deaxx/ptvo_flower_multisensor/README.md

# PTVO Flower multiSensor

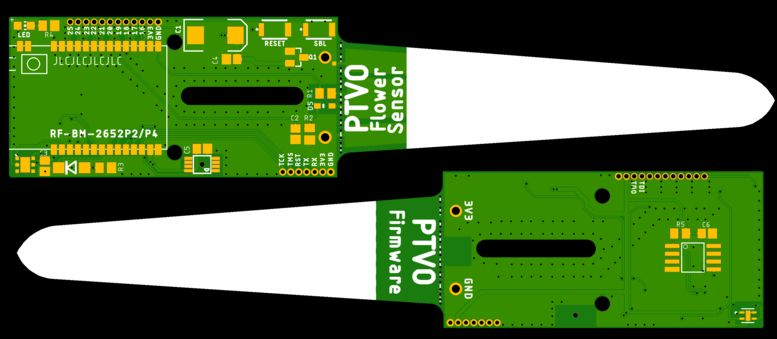
[picture p1: ptvo_fs.jpg]
Top layer
