deaxx/ptvo_flower_multisensor/CC2652RB/README.md

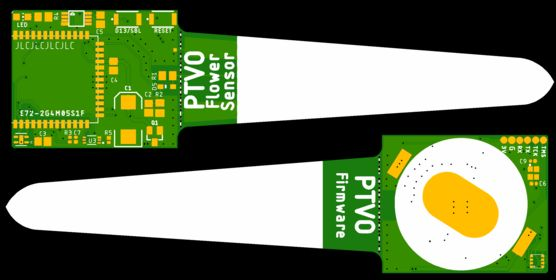
[picture p2: CC2652RB/ptvo_fs.jpg]
Top layer


### Components:
E72-2G4M05S1F - https://aliexpress.ru/item/1005006060110453.html

Cell Holder CR2450 - https://aliexpress.ru/item/33036966276.html

Micro Button Tact Switch SMD 2Pin - https://aliexpress.ru/item/1005001629364313.html

DS18B20U MSOP-8 - https://aliexpress.ru/item/32903017916.html

Quartz Oscillator 48 MHz - https://aliexpress.ru/item/1005001781710042.html

### Information:

For lower power consumption of the E72-2G4M05S1F module, it is recommended to install a quartz oscillator at 48 MHz.

With a 48 MHz quartz oscillator installed, flash the E72-2G4M05S1F module with PTVO firmware for the CC2652R chip
