deaxx/ptvo_flower_multisensor/CC2652RB/ptvo_fs.png

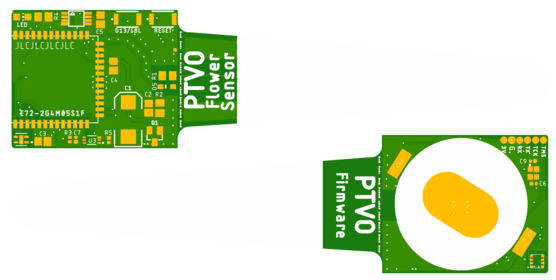
CC2652RB/ptvo_fs.png
