deaxx/ptvo_flower_multisensor/CC2652RB/ptvo_fs_sch.png

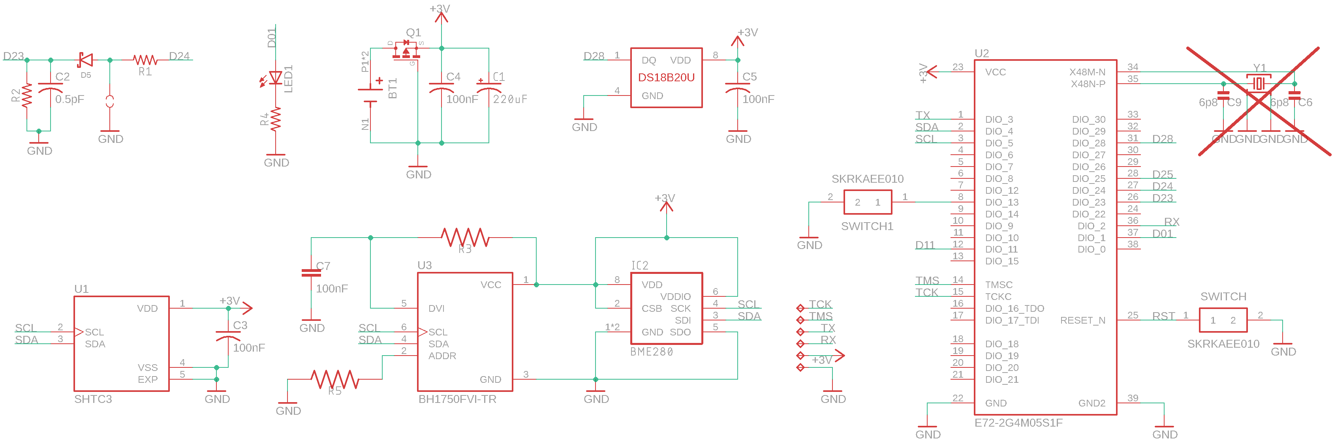
CC2652RB/ptvo_fs_sch.png
