deaxx/ptvo_flower_multisensor/ptvo_fs.png

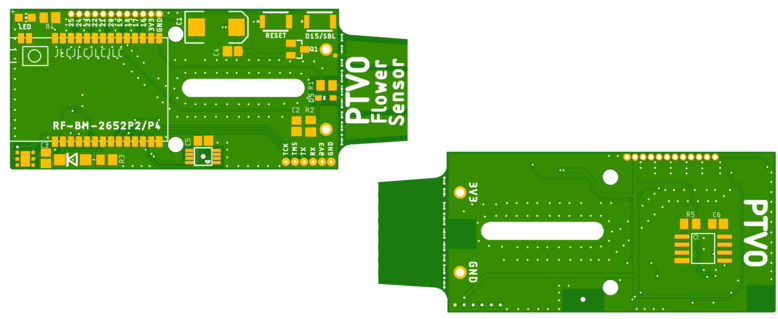
ptvo_fs.png
