deaxx/ptvo_flower_multisensor/ptvo_fs_sch.png

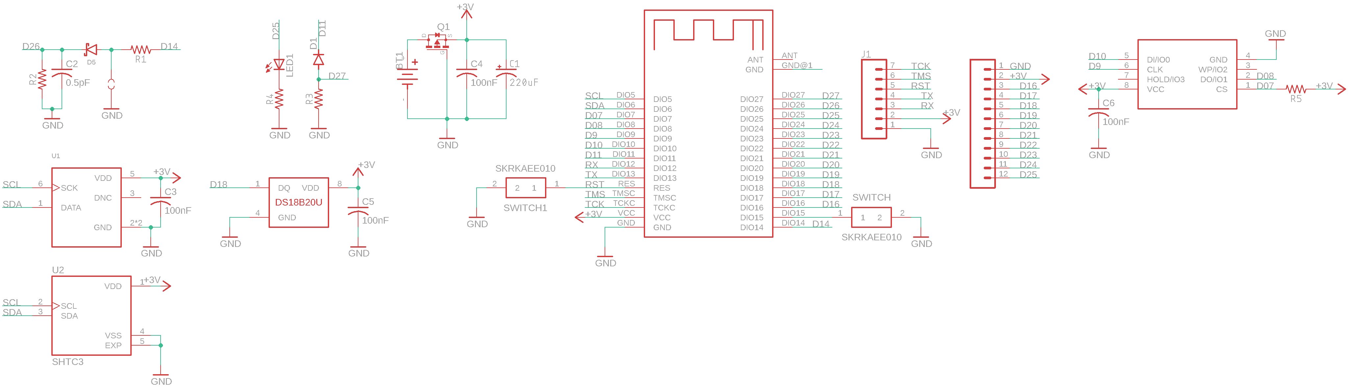
ptvo_fs_sch.png
