deaxx/ptvo_flower_multisensor/ptvo_fs_bom.xls

Qty | Value | Device | Package | Parts | Links
1 |  | LEDCHIP-LED0805 | CHIP-LED0805 | LED1 | https://aliexpress.ru/item/4000936781234.html
1 |  | RF-BM-2652P2 | RF-BM-2652P2 | U$1 | https://aliexpress.ru/item/1005001677721370.html
1 | 0.5pF | C-USC0805 | C0805 | C2
4 | 100nF | C-USC0805 | C0805 | C3, C4, C5, C6
2 | 10k | R-US_M0805 | M0805 | R1, R3
1 | 1M | R-US_M0805 | M0805 | R2
1 | 1N4148WS | DIODE-SCHOTTKY | SOD-323 | D5 | https://aliexpress.ru/item/32921490945.html
2 | 2.2k | R-US_M0805 | M0805 | R4, R5
1 | 220uF | 100UF-POLAR-EIA7343-10V-10%(TANT) | EIA7343 | C1 | https://aliexpress.ru/item/1005002065363485.html
1 | BH2AAAPC | BH2AAAPC | BAT_BH2AAAPC | BT1 | https://aliexpress.ru/item/1005003172823044.html
1 | DS18S20USOP8 | DS18S20USOP8 | UMAX8 | IC1 | https://aliexpress.ru/item/1005004662413243.html
1 | HTU21D | HTU21D | QFN100P300X300X100-7N | U1 | https://aliexpress.ru/item/1005005345789993.html
1 | IS25LP080D | W25Q80BVSNIG | SO-8 | U$2 | https://aliexpress.ru/item/32898528477.html
1 | PTSMD3528 | DIODE-DO214BA | DO214BA | D1 | https://aliexpress.ru/item/1005005334593298.html
1 | SI2323DS | SI2323DS | SOT23 | Q1 | https://aliexpress.ru/item/1005003928154282.html
2 | SKRKAEE010 | SKRKAEE010 | SKRK | SWITCH, SWITCH1 | https://aliexpress.ru/item/32996753966.html
1 | SHTC3 | SHTC3 | SON100P200X200X80-5N | U2 | https://aliexpress.ru/item/1005005492313006.html
