deaxx/ptvo_flower_multisensor/CC2652RB/ptvo_fs.brd

## EAGLE design CC2652RB/ptvo_fs.brd (2024-04-08)

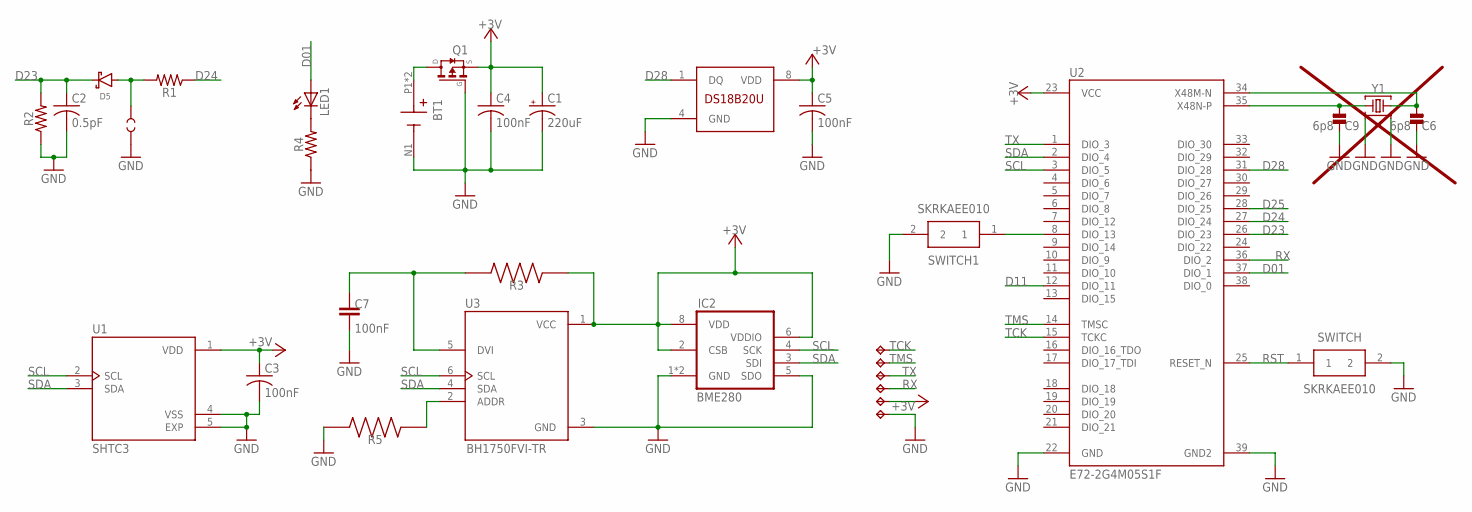
[picture p7: schematic ptvo_fs.sch]

Parts:
BT1: BAT-HLD-001; BAT_BAT-HLD-001
C1: 220uF; EIA7343
C2: 0.5pF; C0805
C3, C4, C5: 100nF; C0805
C6, C9: 6p8; _PKG_C_0402
C7: 100nF; CAPC1005X40N
D5: 1N4148WS; SOD-323
IC1: DS18S20USOP8; UMAX8
IC2: BME280
LED1: LEDCHIP-LED0805; CHIP-LED0805
Q1: SI2323DS; SOT23
R1: 10k; M0805
R2: 1M; M0805
R3, R5: 4.7k; RESC1005X40N
R4: 2.2k; M0805
SWITCH, SWITCH1: SKRKAEE010; SKRK
TP1, TP2: TEST-POINT2; PAD.02X.02
TP3, TP4, TP5, TP6, TP7, TP8: TPB1,27; B1,27
U1: SHTC3; SON100P200X200X80-5N
U2: E72-2G4M05S1F
U3: BH1750FVI-TR; XDCR_BH1750FVI-TR
Y1: Q22FA12800150; XTAL-4P-2016

Connections:
+3V3: C1.A (+), C3.1, C4.1, C5.1, IC1.8 (VDD), IC2.2 (CSB), IC2.6 (VDDIO), IC2.8 (VDD), Q1.2 (S), R3.1, TP6.TP, U1.1 (VDD), U2.23 (VCC), U3.1 (VCC)
D01: LED1.A, U2.37 (DIO_1)
D11: U2.12 (DIO_11)
D23: C2.1, D5.C, R2.2, U2.26 (DIO_23)
D24: R1.1, U2.27 (DIO_24)
D25: U2.28 (DIO_25)
D28: IC1.1 (DQ), U2.31 (DIO_28)
GND: BT1.N1 (-), C1.C (-), C2.2, C3.2, C4.2, C5.2, C6.1, C7.2, C9.1, IC1.4 (GND), IC2.1 (GND), IC2.5 (SDO), IC2.7 (GND), Q1.1 (G), R2.1, R4.1, R5.2, SWITCH.2, SWITCH1.2, TP2.P$1, TP7.TP, U1.4 (VSS), U1.5 (EXP), U2.22 (GND), U2.39 (GND2), U3.3 (GND), Y1.2, Y1.4
unnamed: D5.A, R1.2, TP1.P$1
unnamed: LED1.C, R4.2
unnamed: SWITCH1.1, U2.8 (DIO_13)
unnamed: BT1.P1 (+), BT1.P2 (+), Q1.3 (D)
unnamed: C6.2, U2.34 (X48M-N), Y1.3
unnamed: C7.1, R3.2, U3.5 (DVI)
unnamed: R5.1, U3.2 (ADDR)
unnamed: C9.2, U2.35 (X48N-P), Y1.1
RST: SWITCH.1, U2.25 (RESET_N)
RX: TP5.TP, U2.36 (DIO_2)
SCL: IC2.4 (SCK), U1.2 (SCL), U2.3 (DIO_5), U3.6 (SCL)
SDA: IC2.3 (SDI), U1.3 (SDA), U2.2 (DIO_4), U3.4 (SDA)
TCK: TP8.TP, U2.15 (TCKC)
TMS: TP3.TP, U2.14 (TMSC)
TX: TP4.TP, U2.1 (DIO_3)

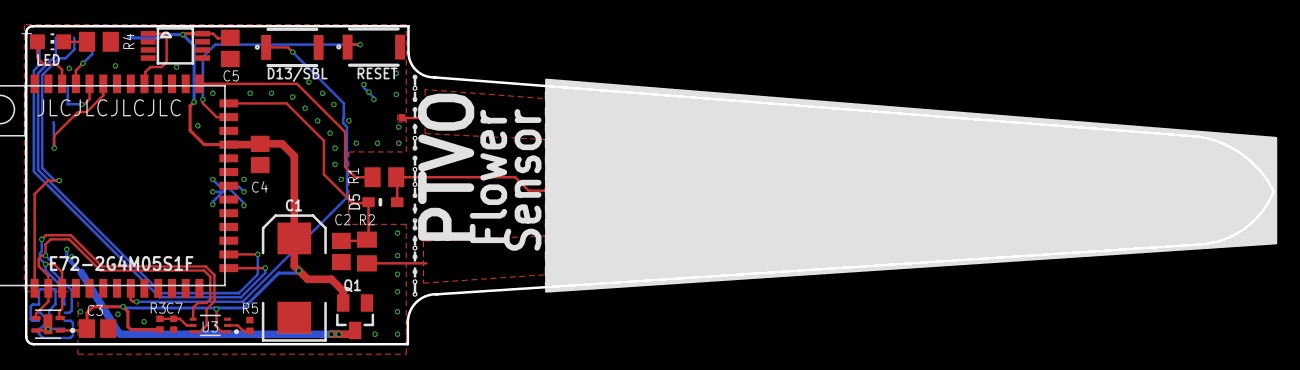
[picture p8: board CC2652RB/ptvo_fs.brd from above]

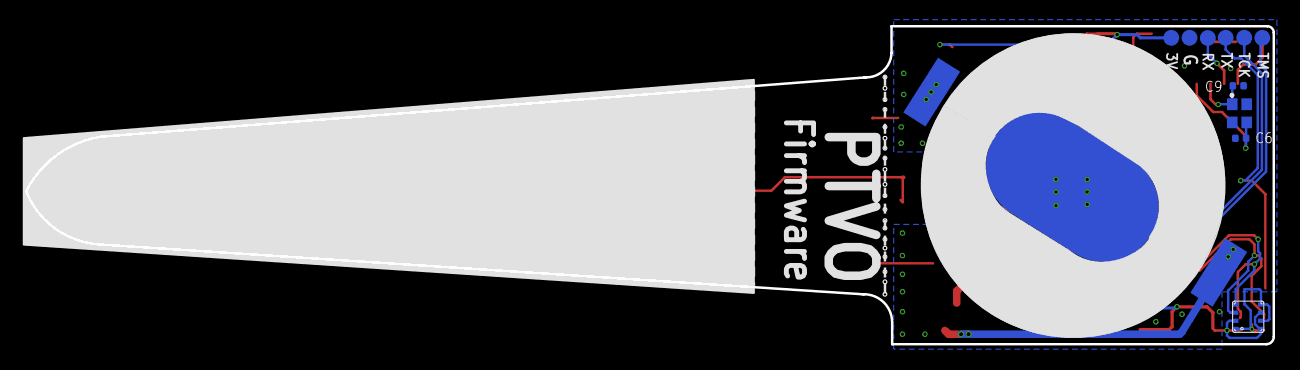
[picture p9: board CC2652RB/ptvo_fs.brd from below]

Board: 2 copper layers, 100.0 x 25.5 mm, 33 parts (11 on the bottom side), 21 nets.
