deaxx/ptvo_flower_multisensor/ptvo_fs.brd

## EAGLE design ptvo_fs.brd (2023-12-28)

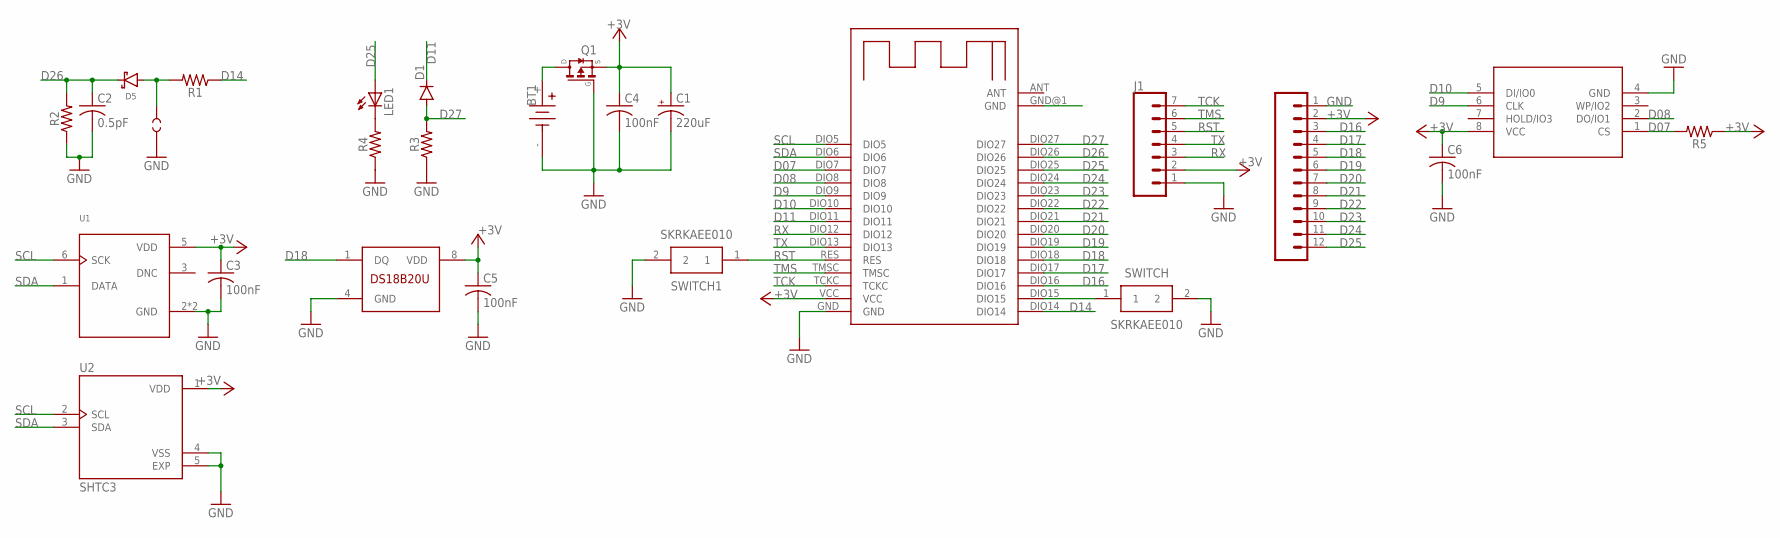
[picture p10: schematic ptvo_fs.sch]

Parts:
BT1: BH2AAAPC; BAT_BH2AAAPC
C1: 220uF; EIA7343
C2: 0.5pF; C0805
C3, C4, C5, C6: 100nF; C0805
D1: PTSMD3528; DO214BA
D5: 1N4148WS; SOD-323
IC1: DS18S20USOP8; UMAX8
J1, J2: CONN_051.27MM; 1X05_1.27MM
LED1: LEDCHIP-LED0805; CHIP-LED0805
Q1: SI2323DS; SOT23
R1, R3: 10k; M0805
R2: 1M; M0805
R4, R5: 2.2k; M0805
SWITCH, SWITCH1: SKRKAEE010; SKRK
TP1, TP2: TEST-POINT2; PAD.02X.02
U1: HTU21D; QFN100P300X300X100-7N
U2: SHTC3; SON100P200X200X80-5N
U$1: RF-BM-2652P2
U$2: IS25LP080D; SO-8

Connections:
+3V3: C1.A (+), C3.1, C4.1, C5.1, C6.1, IC1.8 (VDD), J1.2, J2.2, Q1.2 (S), R5.1, U1.5 (VDD), U2.1 (VDD), U$1.VCC, U$2.8 (VCC)
D07: R5.2, U$1.DIO7, U$2.1 (CS)
D08: U$1.DIO8, U$2.2 (DO/IO1)
D9: U$1.DIO9, U$2.6 (CLK)
D10: U$1.DIO10, U$2.5 (DI/IO0)
D11: D1.C, U$1.DIO11
D14: R1.1, U$1.DIO14
D16: J2.3, U$1.DIO16
D17: J2.4, U$1.DIO17
D18: IC1.1 (DQ), J2.5, U$1.DIO18
D19: J2.6, U$1.DIO19
D20: J2.7, U$1.DIO20
D21: J2.8, U$1.DIO21
D22: J2.9, U$1.DIO22
D23: J2.10, U$1.DIO23
D24: J2.11, U$1.DIO24
D25: J2.12, LED1.A, U$1.DIO25
D26: C2.1, D5.C, R2.2, U$1.DIO26
D27: D1.A, R3.2, U$1.DIO27
GND: BT1.-, C1.C (-), C2.2, C3.2, C4.2, C5.2, C6.2, IC1.4 (GND), J1.1, J2.1, Q1.1 (G), R2.1, R3.1, R4.1, SWITCH.2, SWITCH1.2, TP2.P$1, U1.2 (GND), U1.PAD (GND), U2.4 (VSS), U2.5 (EXP), U$1.GND, U$2.4 (GND)
unnamed: D5.A, R1.2, TP1.P$1
unnamed: LED1.C, R4.2
unnamed: SWITCH.1, U$1.DIO15
unnamed: BT1.+, Q1.3 (D)
RST: J1.5, SWITCH1.1, U$1.RES
RX: J1.3, U$1.DIO12
SCL: U1.6 (SCK), U2.2 (SCL), U$1.DIO5
SDA: U1.1 (DATA), U2.3 (SDA), U$1.DIO6
TCK: J1.7, U$1.TCKC
TMS: J1.6, U$1.TMSC
TX: J1.4, U$1.DIO13

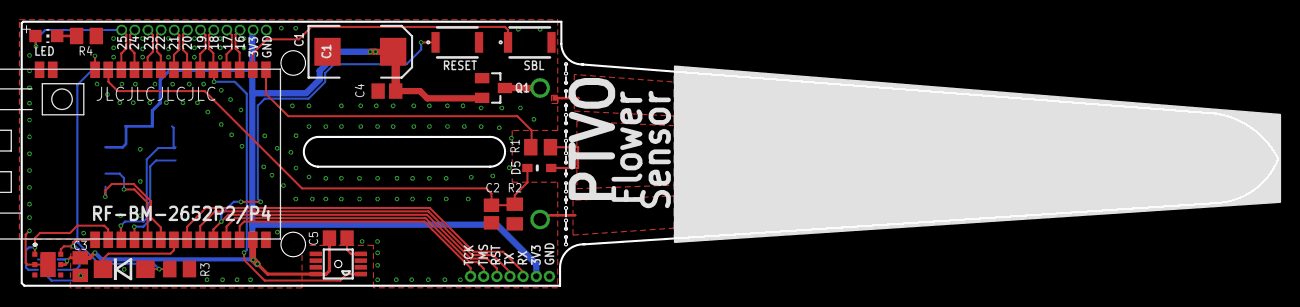
[picture p11: board ptvo_fs.brd from above]

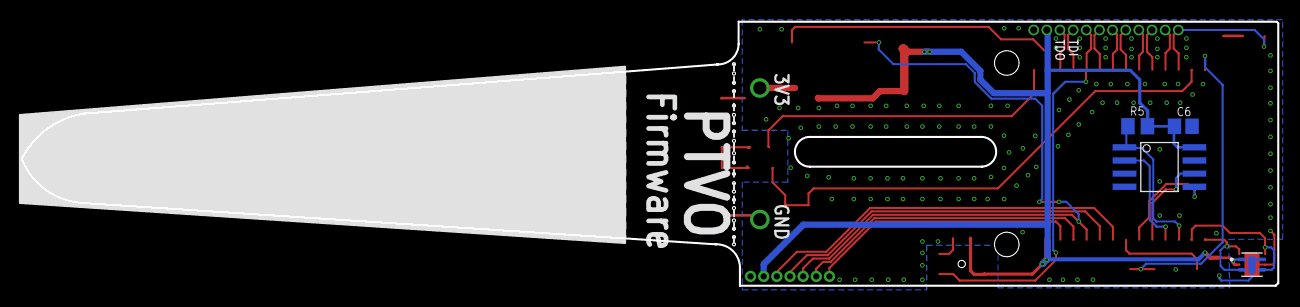
[picture p12: board ptvo_fs.brd from below]

Board: 2 copper layers, 121.4 x 25.5 mm, 27 parts (5 on the bottom side), 31 nets.
